ronaldwilson246/Taylor-Cells-Controller/README.md

# Taylor-Cells-Controller
Refer "User Manual.pdf" for more information <br />

Project Status  : Completed <br />
Project Timeline: 20th December 2016 to 5th April 2017 <br />
Permissions     : Dr. Ranga Narayanan<br /> 
Link            : http://www.che.ufl.edu/faculty/narayanan/index.html <br />
